MGraefe/geiger/eagle/geiger_schematic.pdf

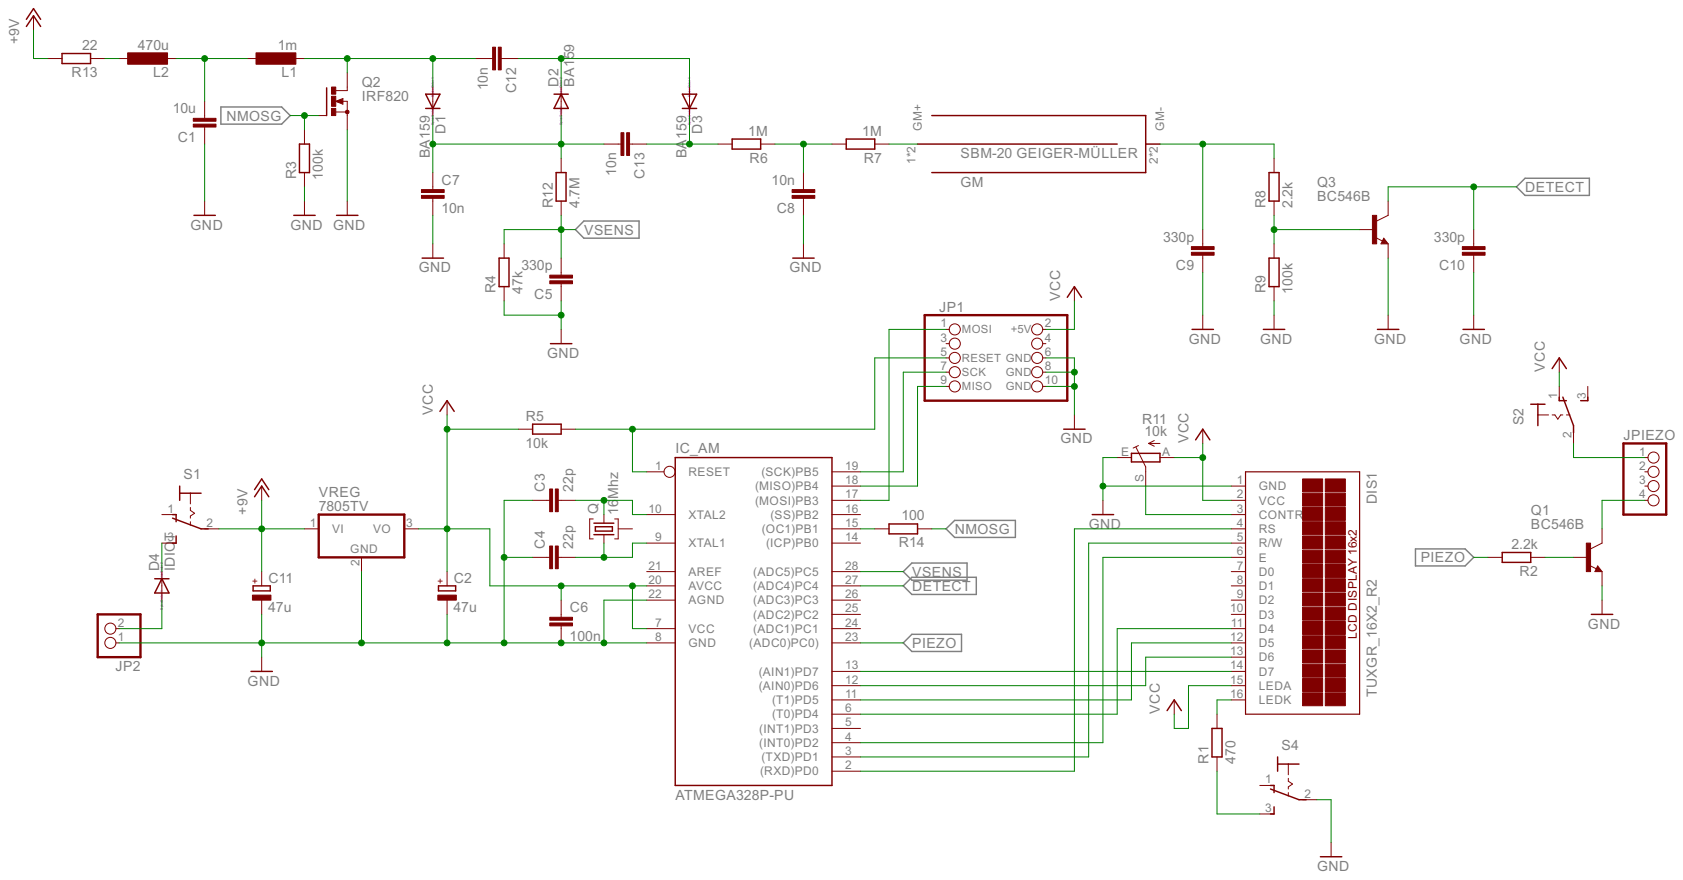
[picture p1: page 1]

5 4
