MGraefe/geiger/eagle/geiger_board.pdf

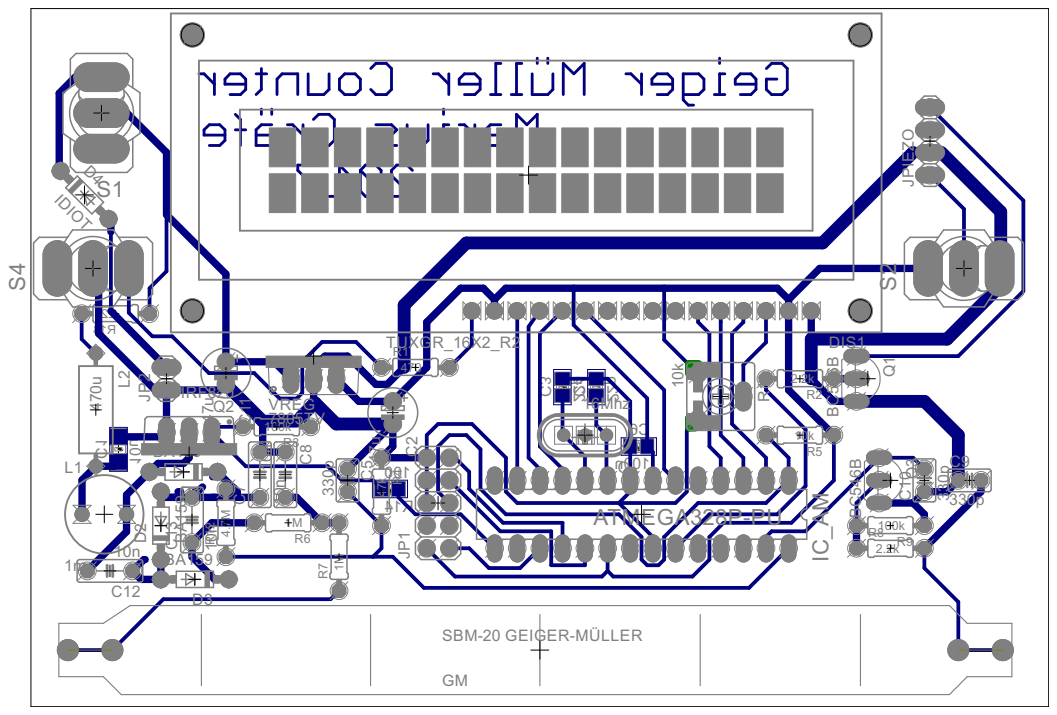
[picture p2: page 1]
