MGraefe/geiger/eagle/geiger_mask.pdf

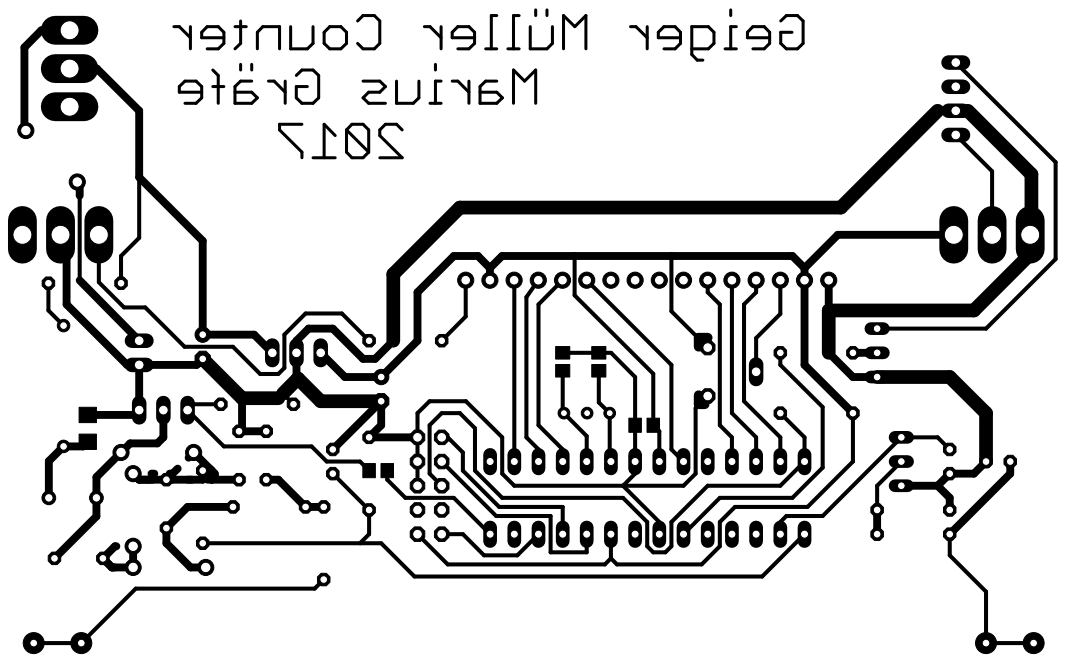
[picture p3: page 1]
