MGraefe/geiger/eagle/geiger.brd

## EAGLE design eagle/geiger.brd (2018-11-13)

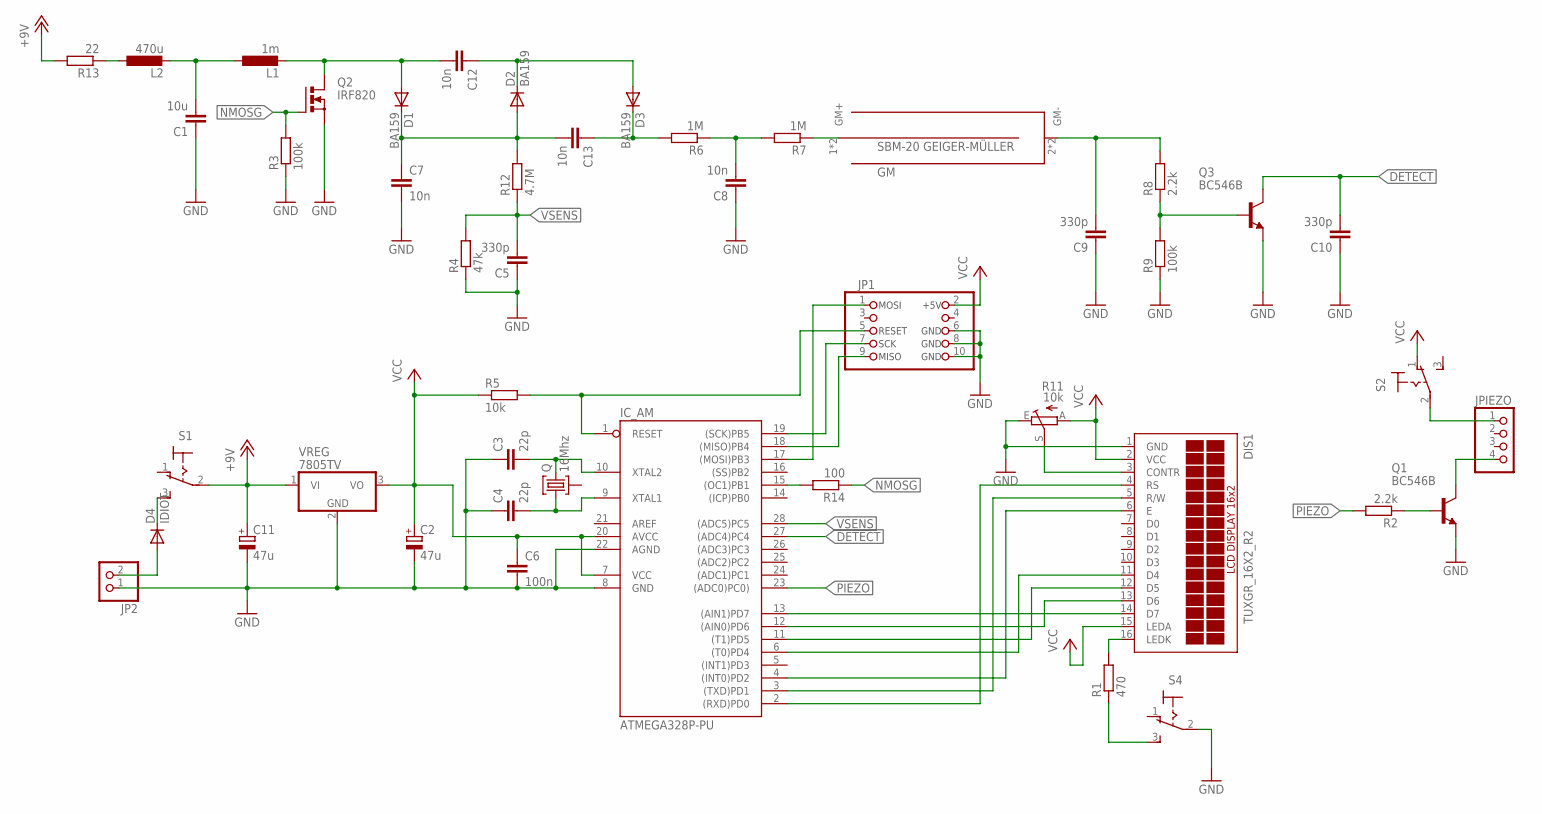
[picture p4: schematic geiger.sch]

Parts:
C1: 10u; C1206
C2, C11: 47u; E2,5-6
C3, C4: 22p; C0805
C5, C9, C10: 330p; C025-025X050
C6: 100n; C0805
C7, C8, C12, C13: 10n; C050-025X075
D1, D2, D3: BA159; DO41-7.6
D4: IDIOT; DO41-7.6
DIS1: TUXGR_16X2_R2
GM: SBM-20
IC_AM: ATMEGA328P-PU; DIL28-3
JP1: ISP10-M; 2X05
JP2: PINHD-1X2; 1X02
JPIEZO: PINHD-1X4; 1X04
L1: 1m; 6000-XXXX-RC
L2: 470u; 2200-12.7
Q: 16Mhz; HC49U
Q1, Q3: BC546B; TO92-EBC
Q2: IRF820; TO220BV
R1: 470; 0204/7
R2, R8: 2.2k; 0204/7
R3, R9: 100k; 0204/7
R4: 47k; 0204/7
R5: 10k; 0204/7
R6, R7: 1M; 0204/7
R11: 10k; CA6V
R12: 4.7M; 0204/7
R13: 22; 0204/7
R14: 100; R0805
S1, S2, S4: 320-916
VREG: 7805TV; TO220V

Connections:
+9V: C11.+, R13.2, S1.2, VREG.1 (VI)
DETECT: C10.2, IC_AM.27 ((ADC4)PC4), Q3.C
GND: C1.1, C2.-, C3.1, C4.1, C5.1, C6.2, C7.2, C8.1, C9.1, C10.1, C11.-, DIS1.1 (GND), IC_AM.8 (GND), IC_AM.22 (AGND), JP1.6, JP1.8, JP1.10, JP2.1, Q1.E, Q2.S, Q3.E, R3.1, R4.1, R9.1, R11.E, S4.2, VREG.2 (GND)
MISO: IC_AM.18 ((MISO)PB4), JP1.9
MOSI: IC_AM.17 ((MOSI)PB3), JP1.1
unnamed: DIS1.14 (D7), IC_AM.13 ((AIN1)PD7)
unnamed: DIS1.13 (D6), IC_AM.12 ((AIN0)PD6)
unnamed: DIS1.12 (D5), IC_AM.11 ((T1)PD5)
unnamed: DIS1.11 (D4), IC_AM.6 ((T0)PD4)
unnamed: DIS1.3 (CONTR), R11.S
unnamed: DIS1.6 (E), IC_AM.4 ((INT0)PD2)
unnamed: DIS1.5 (R/W), IC_AM.3 ((TXD)PD1)
unnamed: DIS1.4 (RS), IC_AM.2 ((RXD)PD0)
unnamed: C7.1, C13.2, D1.C, D2.A, R12.2
unnamed: DIS1.16 (LEDK), R1.2
unnamed: JPIEZO.4, Q1.C
unnamed: Q1.B, R2.1
unnamed: C8.2, R6.1, R7.2
unnamed: C9.2, GM.2 (GM-), GM.4 (GM-), R8.2
unnamed: GM.1 (GM+), GM.3 (GM+), R7.1
unnamed: D4.A, JP2.2
unnamed: Q3.B, R8.1, R9.2
unnamed: JPIEZO.1, S2.2
unnamed: R1.1, S4.3 (S)
unnamed: C12.1, D2.C, D3.A
unnamed: C1.2, L1.1, L2.2
unnamed: L2.1, R13.1
unnamed: IC_AM.15 ((OC1)PB1), R14.2
unnamed: C12.2, D1.A, L1.2, Q2.D
unnamed: C13.1, D3.C, R6.2
unnamed: D4.C, S1.3 (S)
NMOSG: Q2.G, R3.2, R14.1
PIEZO: IC_AM.23 ((ADC0)PC0)), R2.2
RESET: IC_AM.1 (RESET), JP1.5, R5.2
SCK: IC_AM.19 ((SCK)PB5), JP1.7
VCC: C2.+, C6.1, DIS1.2 (VCC), DIS1.15 (LEDA), IC_AM.7 (VCC), IC_AM.20 (AVCC), JP1.2, R5.1, R11.A, S2.1 (O), VREG.3 (VO)
VSENS: C5.2, IC_AM.28 ((ADC5)PC5), R4.2, R12.1
XTAL1: C4.2, IC_AM.9 (XTAL1), Q.1
XTAL2: C3.2, IC_AM.10 (XTAL2), Q.3

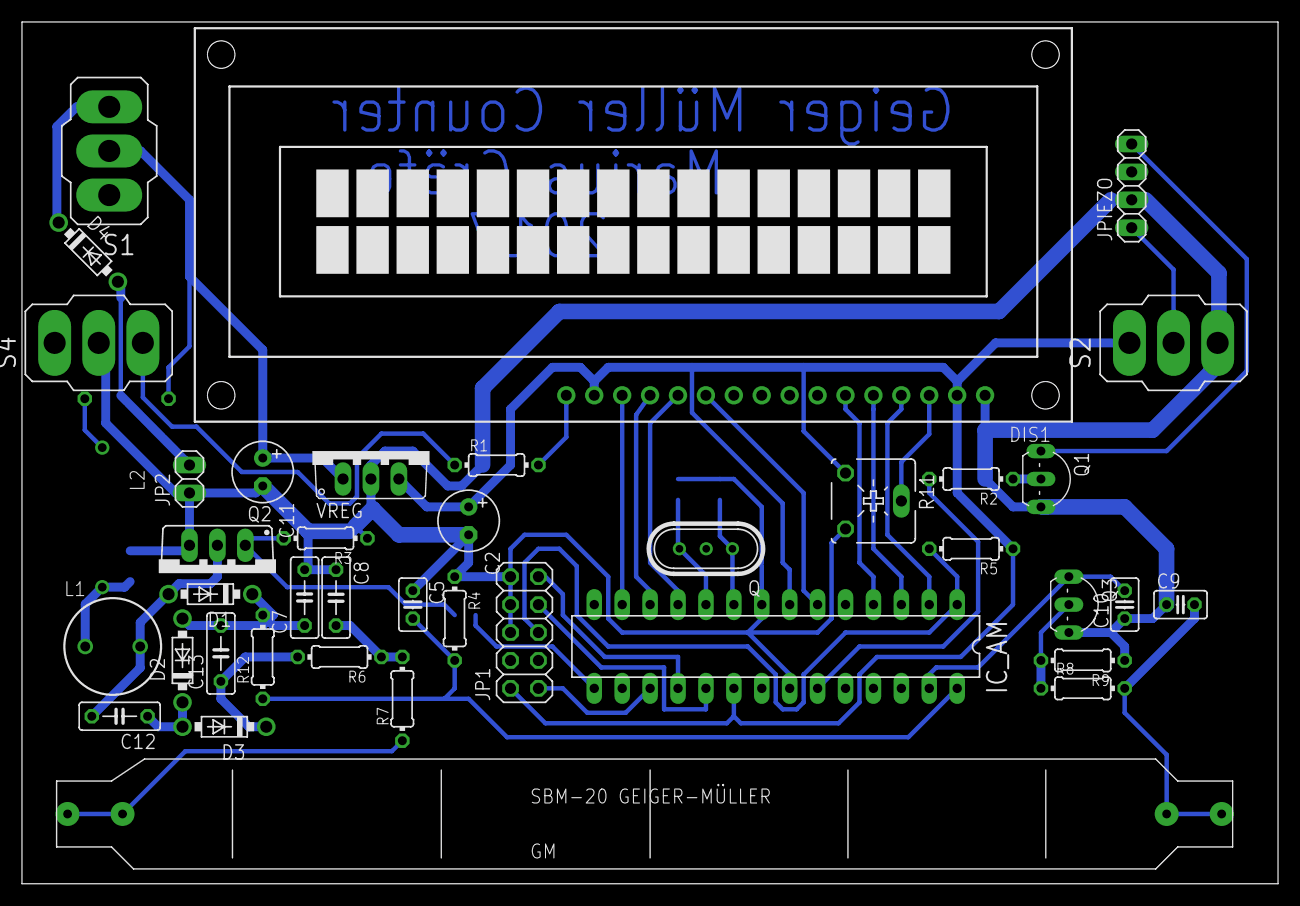
[picture p5: board geiger.brd from above]

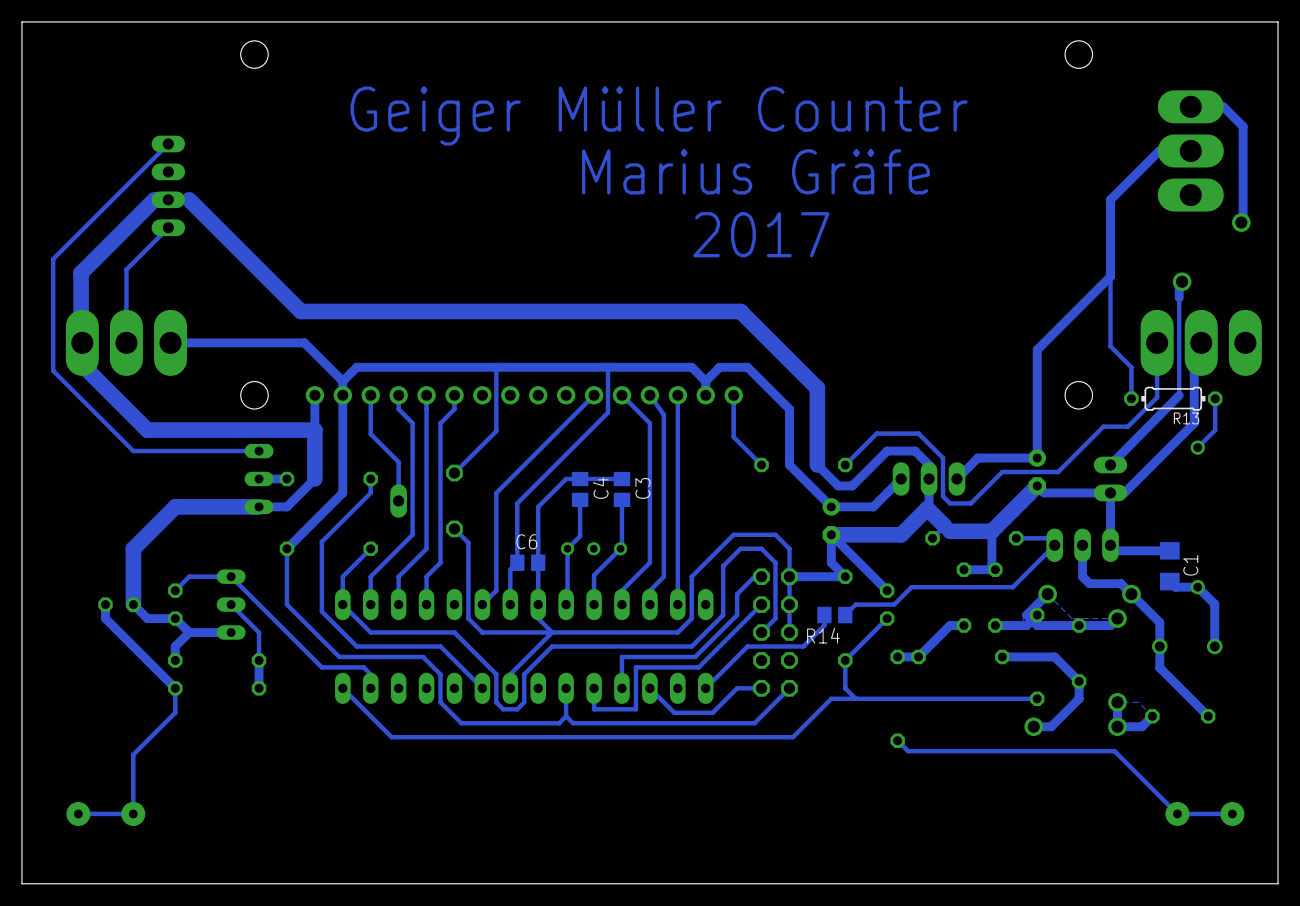
[picture p6: board geiger.brd from below]

Board: 2 copper layers, 114.3 x 78.4 mm, 46 parts (6 on the bottom side), 39 nets.
