MGraefe/geiger/(commit log)

2017-02-07 Added cpm calculation, output and power reduction
2018-11-13 Added schematics and board layout
    [geiger.brd, geiger.sch]
